craigyjp/FV-1-programmable-multi-effect/schematics/FV-1_programmer.pdf

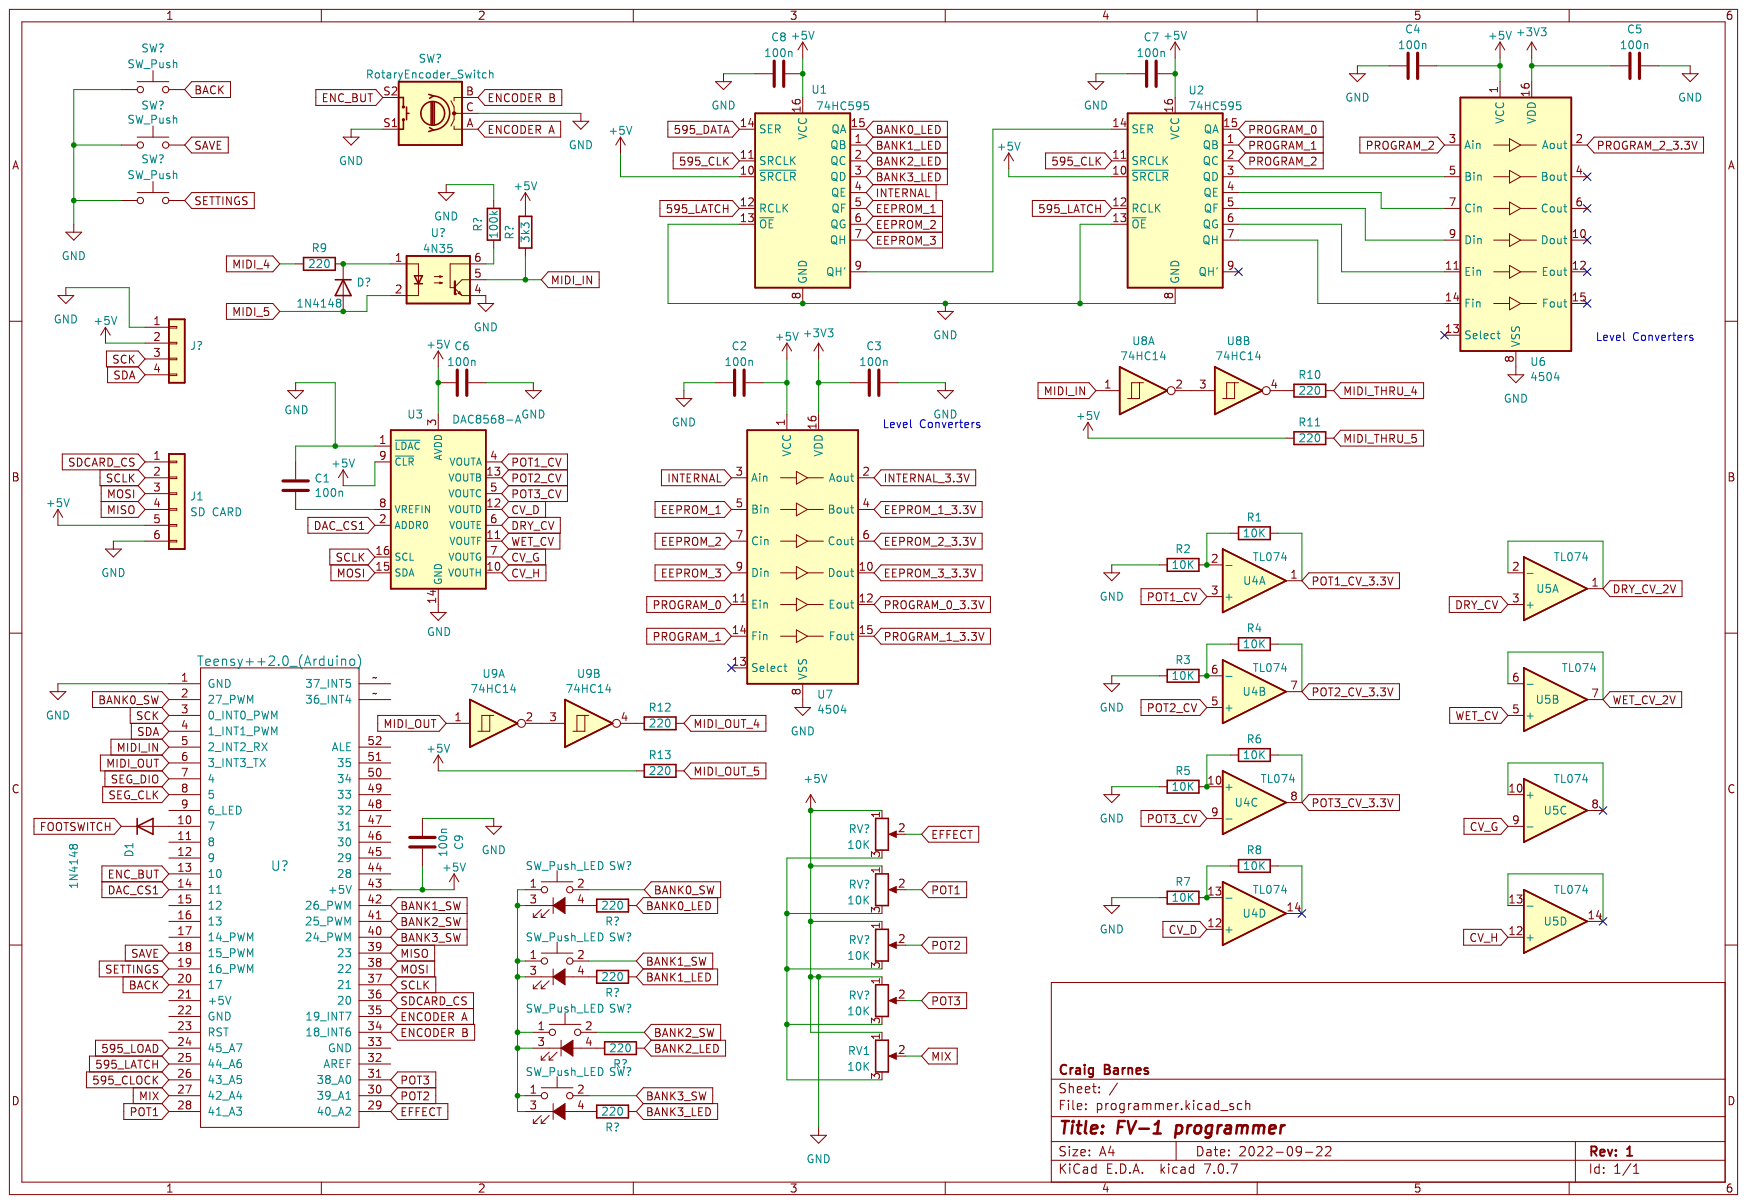
[picture p2: page 1]
