craigyjp/FV-1-programmable-multi-effect/schematics/VU-Meters.pdf

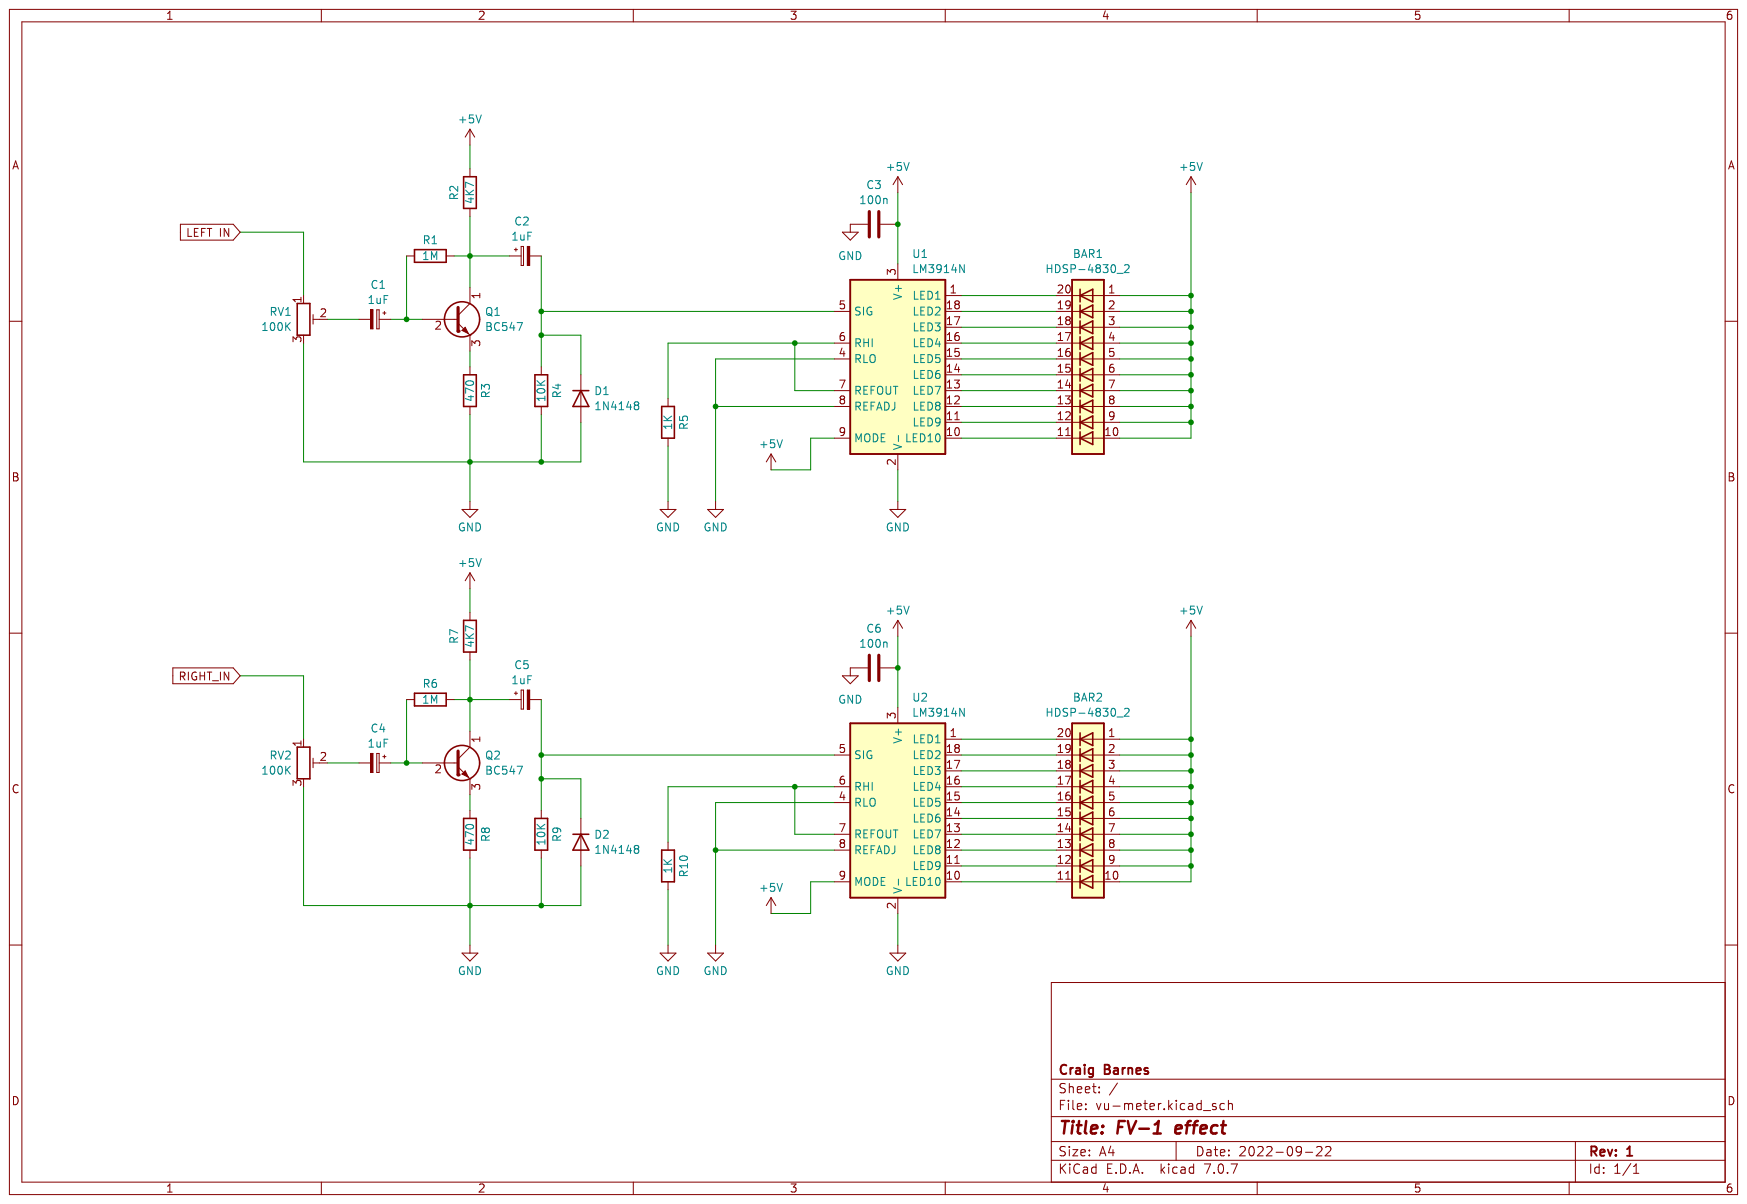
[picture p3: page 1]
