craigyjp/FV-1-programmable-multi-effect/schematics/FV1-effect.pdf

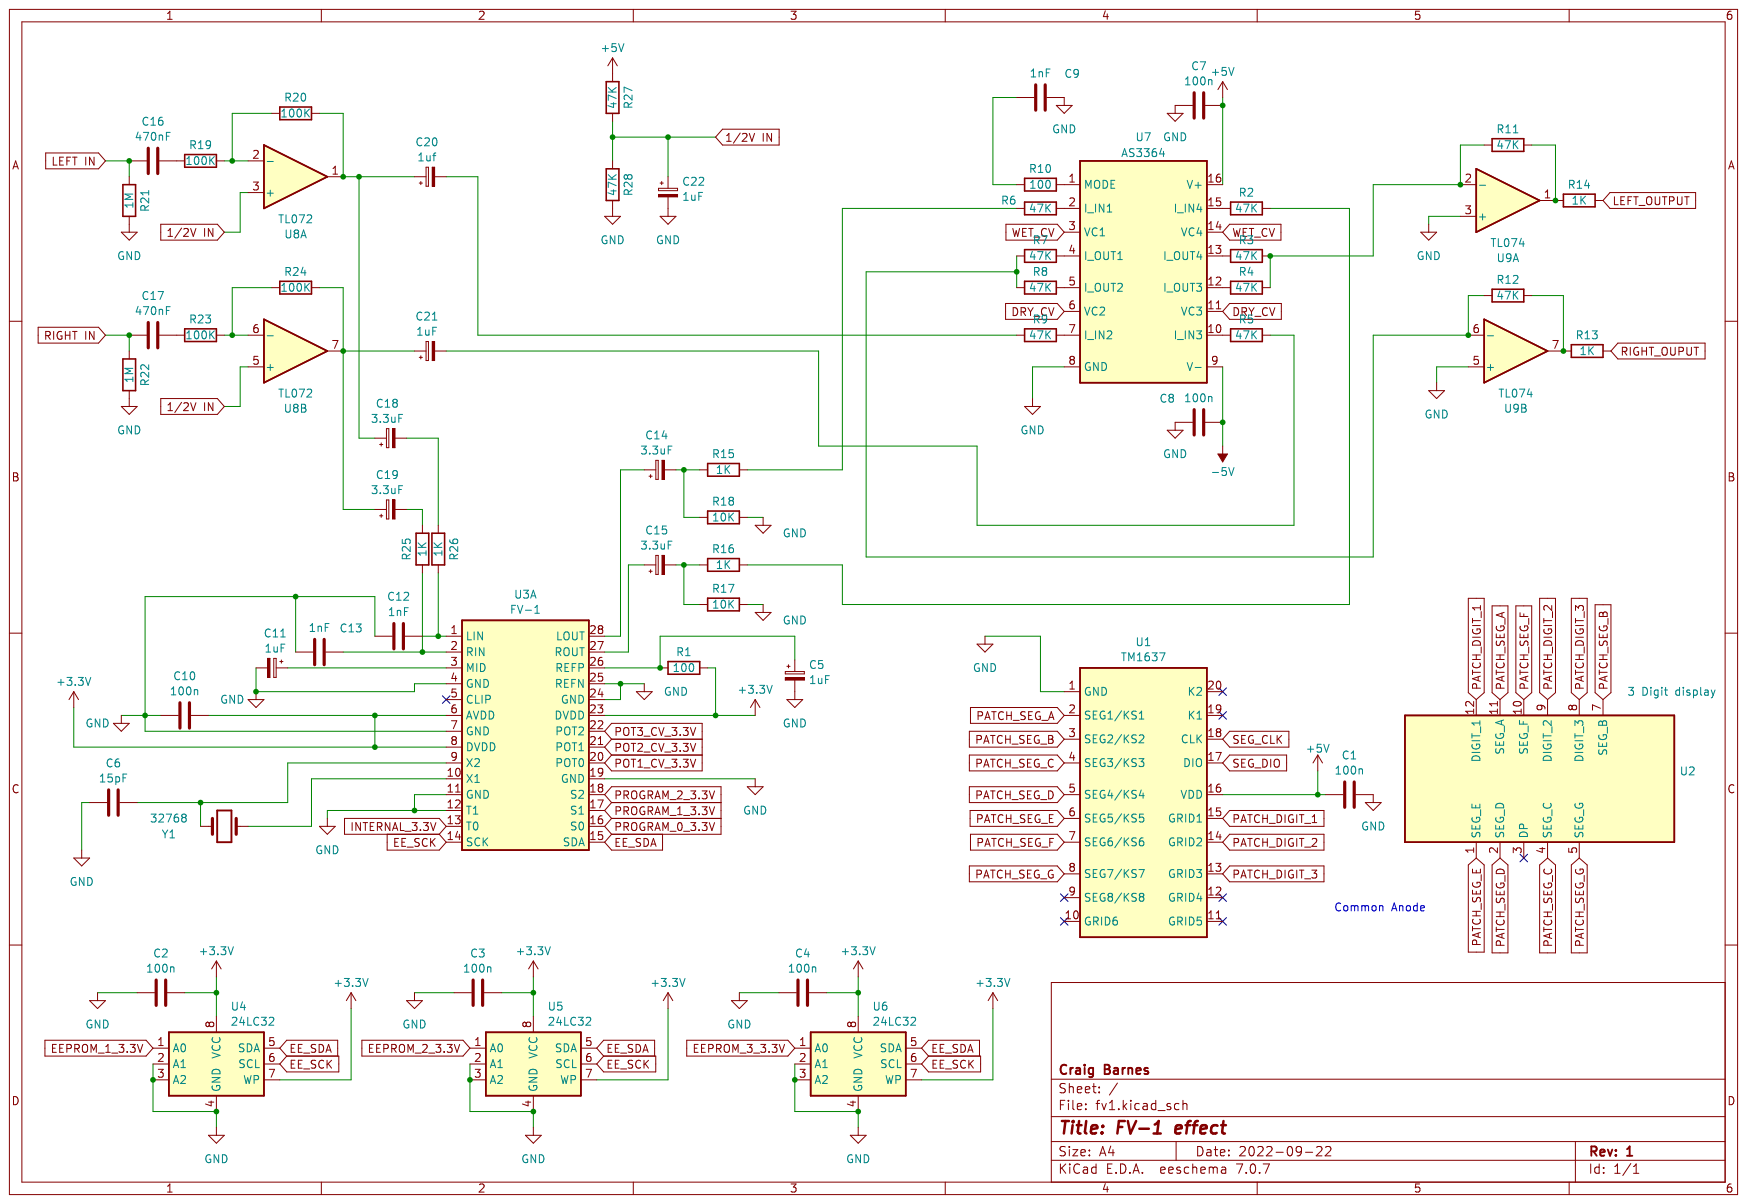
[picture p4: page 1]
