craigyjp/FV-1-programmable-multi-effect/eeproms/effects.h

const uint8_t phaserbass[] PROGMEM = {
0x0E, 0xB8, 0x04, 0x04, 0x80, 0x00, 0x00, 0x0D, 0x13, 0x33, 0x04, 0x84, 0x40, 0x00, 0x04, 0x86, 
0x80, 0x00, 0x00, 0x0D, 0x2C, 0xCC, 0x04, 0x24, 0x40, 0x00, 0x04, 0x26, 0xEC, 0xCD, 0x04, 0x44, 
0x13, 0x33, 0x04, 0x46, 0x00, 0x00, 0x04, 0x66, 0x40, 0x00, 0x02, 0x44, 0xC0, 0x11, 0x7F, 0xCD, 
0x00, 0x00, 0x04, 0xA6, 0x40, 0x00, 0x04, 0xA4, 0x00, 0x00, 0x04, 0xAA, 0x00, 0x00, 0x04, 0xC6, 
0x40, 0x00, 0x04, 0xC4, 0xC6, 0x67, 0x73, 0x2D, 0x00, 0x00, 0x04, 0xE6, 0x40, 0x00, 0x02, 0x84, 
0x00, 0x00, 0x05, 0x06, 0x40, 0x00, 0x04, 0x64, 0x00, 0x00, 0x04, 0xEA, 0x40, 0x00, 0x05, 0x04, 
0x00, 0x00, 0x05, 0x06, 0x80, 0x20, 0x00, 0x11, 0x20, 0x0F, 0xFF, 0xF2, 0x40, 0x00, 0x02, 0x24, 
0x39, 0x99, 0x06, 0xA4, 0x00, 0x00, 0x06, 0xA6, 0x40, 0x00, 0x02, 0x04, 0x00, 0x00, 0x02, 0x0A, 
0x35, 0x1E, 0x00, 0x4D, 0x00, 0x00, 0x00, 0x46, 0xC2, 0x20, 0x00, 0x14, 0x20, 0x00, 0x40, 0x0D, 
0x20, 0x00, 0x00, 0x0B, 0x40, 0x00, 0x00, 0x0C, 0x40, 0x00, 0xC0, 0x0D, 0x7F, 0xEF, 0x00, 0x0D, 
0x00, 0x00, 0x02, 0x2A, 0x09, 0x99, 0x6A, 0x2D, 0x00, 0x00, 0x06, 0xC6, 0x40, 0x00, 0x05, 0x44, 
0x40, 0x00, 0x06, 0x46, 0x00, 0x00, 0x06, 0xCA, 0x01, 0x00, 0x05, 0x04, 0xC0, 0x00, 0x05, 0x46, 
0x00, 0x00, 0x06, 0xCA, 0x40, 0x00, 0x06, 0x44, 0x00, 0x00, 0x06, 0x66, 0x40, 0x00, 0x05, 0x64, 
0x40, 0x00, 0x06, 0x46, 0x00, 0x00, 0x06, 0xCA, 0x40, 0x00, 0x06, 0x64, 0xC0, 0x00, 0x05, 0x66, 
0x00, 0x00, 0x06, 0xCA, 0x40, 0x00, 0x06, 0x44, 0x00, 0x00, 0x06, 0x66, 0x40, 0x00, 0x05, 0x84, 
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
0x00, 0x00, 0x00, 0x11, 0x00, 0x00, 0x00, 0x11, 0x00, 0x00, 0x00, 0x11, 0x00, 0x00, 0x00, 0x11, 
0x00, 0x00, 0x00, 0x11, 0x00, 0x00, 0x00, 0x11, 0x00, 0x00, 0x00, 0x11, 0x00, 0x00, 0x00, 0x11, 
0x00, 0x00, 0x00, 0x11, 0x00, 0x00, 0x00, 0x11, 0x00, 0x00, 0x00, 0x11, 0x00, 0x00, 0x00, 0x11, 
};
