craigyjp/FV-1-programmable-multi-effect/(commit log)

2023-11-05 Added large LED patch display
2023-11-05 Added LED display brightness
2023-11-05 fixed some missing wires
